Nathgabet/BE_L3_EEA-REL_PV/docs pour le rapport/MPPT/PV_H.jpg

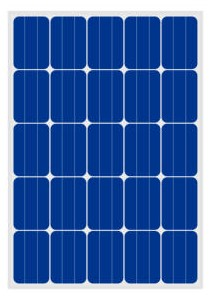
docs pour le rapport/MPPT/PV_H.jpg
