Nathgabet/BE_L3_EEA-REL_PV/docs pour le rapport/Capteur de température/demande de signal plus com.pdf

02/05/2023 15:44:55
Pico Technology www.picotech.com PicoScope 6 Version 6.12.9.2917 PicoScope 3203D MSO

8,0

6,0

4,0

2,0

0,0

-2,0

-4,0

-6,0

-8,0

10,0

-10,0

V
CC
19,73 | 19,86 | 19,98 | 20,11 | 20,24 | 20,36 | 20,49 | 20,62 | 20,74 | 20,87 | 21,0
ms
