Nathgabet/BE_L3_EEA-REL_PV/docs pour le rapport/Capteur de température/signal complet.pdf

02/05/2023 15:44:55
Pico Technology www.picotech.com PicoScope 6 Version 6.12.9.2917 PicoScope 3203D MSO

8,0

6,0

4,0

2,0

0,0

-2,0

-4,0

-6,0

-8,0

10,0

-10,0

V
CC
-0,567 | 1,932 | 4,431 | 6,93 | 9,429 | 11,93 | 14,43 | 16,93 | 19,42 | 21,92 | 24,42
ms
