Nathgabet/BE_L3_EEA-REL_PV/docs pour le rapport/Capteur de température/trame.pdf

02/05/2023 15:44:55
Pico Technology www.picotech.com PicoScope 6 Version 6.12.9.2917 PicoScope 3203D MSO

8,0

6,0

4,0

2,0

0,0

-2,0

-4,0

-6,0

-8,0

10,0

-10,0

V
CC
19,73 | 20,2 | 20,67 | 21,14 | 21,61 | 22,08 | 22,55 | 23,01 | 23,48 | 23,95 | 24,42
ms
