Nathgabet/BE_L3_EEA-REL_PV/docs pour le rapport/Hacheur/AOP/amplificateur_non_inversseur.pdf

21/03/2023 17:08:42
Pico Technology www.picotech.com PicoScope 6 Version 6.12.9.2917 PicoScope 3203D MSO

8,0

6,0

4,0

2,0

0,0

-2,0

-4,0

-6,0

-8,0

10,0

-10,0

V
CC

16,0

12,0

8,0

4,0

0,0

-4,0

-8,0

-12,0

-16,0

20,0

-20,0

V
CC
0,0 | 5,0 | 10,0 | 15,0 | 20,0 | 25,0 | 30,0 | 35,0 | 40,0 | 45,0 | 50,0
ms
