Nathgabet/BE_L3_EEA-REL_PV/Document d'aide/projet_chargeur_de_batterie-par-PV.pdf

# Chargeur de batteries par

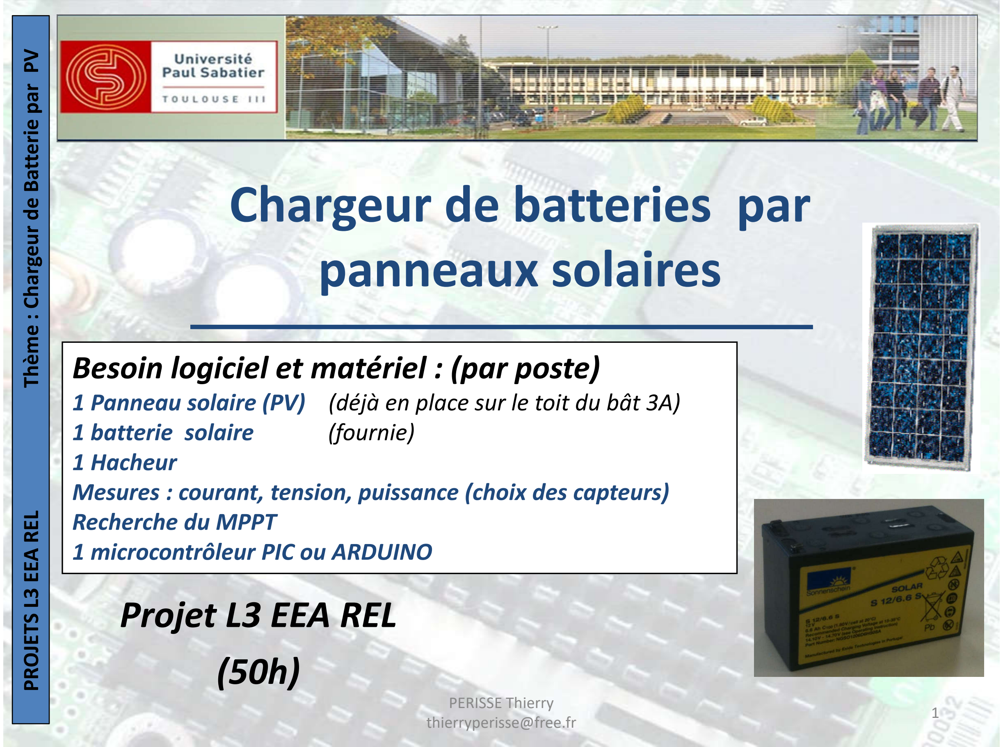
[picture p33: page 1]

PROJETS L3 EEA REL Thème : Chargeur de Batterie par PV

1 PERISSE Thierry
thierryperisse@free.fr

# panneaux solaires

## Besoin logiciel et matériel : (par poste)

### 1 Panneau solaire (PV) (déjà en place sur le toit du bât 3A) 1 batterie solaire (fournie) 1 Hacheur

Mesures : courant, tension, puissance (choix des capteurs) Recherche du MPPT

### 1 microcontrôleur PIC ou ARDUINO

## Projet L3 EEA REL

(50h)

## Chargeur de batteries par panneaux solaires

## L’objectif du projet est de construire un chargeur de

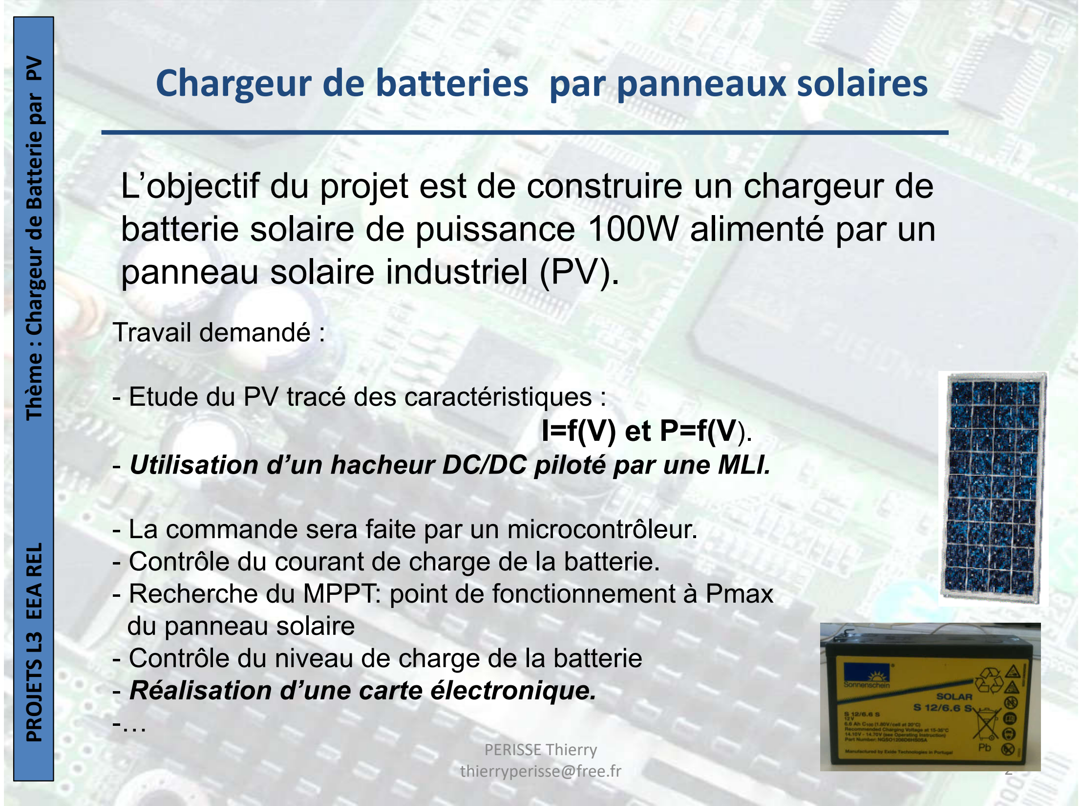
[picture p34: page 2]

PROJETS L3 EEA REL Thème : Chargeur de Batterie par PV

PERISSE Thierry
thierryperisse@free.fr | 2

## batterie solaire de puissance 100W alimenté par un

panneau solaire industriel (PV).

Travail demandé :

- Etude du PV tracé des caractéristiques :
I=f(V) et P=f(V).
- Utilisation d’un hacheur DC/DC piloté par une MLI.
- La commande sera faite par un microcontrôleur.
- Contrôle du courant de charge de la batterie.
- Recherche du MPPT: point de fonctionnement à Pmax du panneau solaire
- Contrôle du niveau de charge de la batterie
- Réalisation d’une carte électronique.
-…
