Nathgabet/BE_L3_EEA-REL_PV/docs pour le rapport/Schéma de cablage/Document1.docx

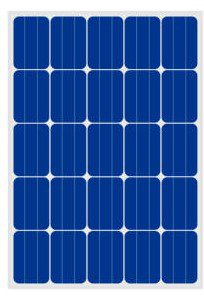
[picture p46: figure]
PV_H
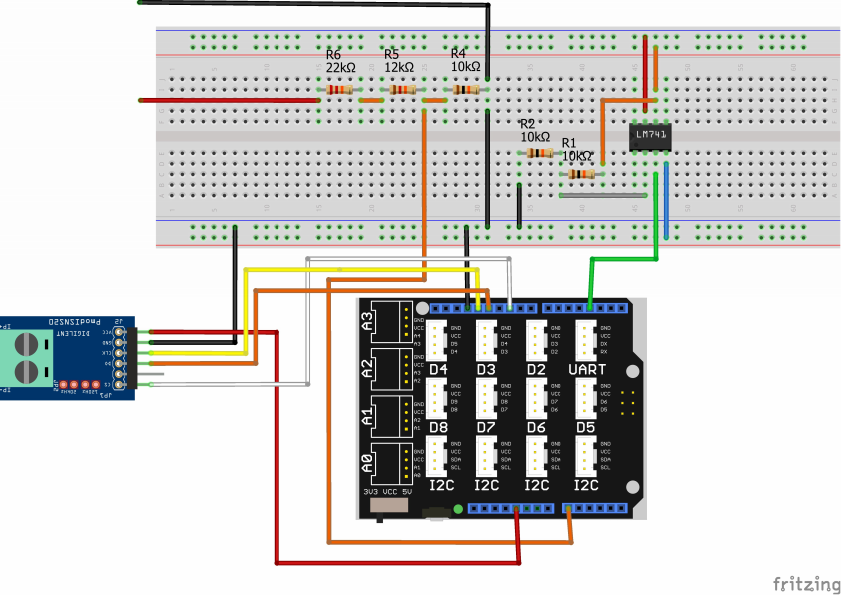
[picture p47: figure]
