Nathgabet/BE_L3_EEA-REL_PV/docs pour le rapport/Schéma de cablage/Document1(1).pdf

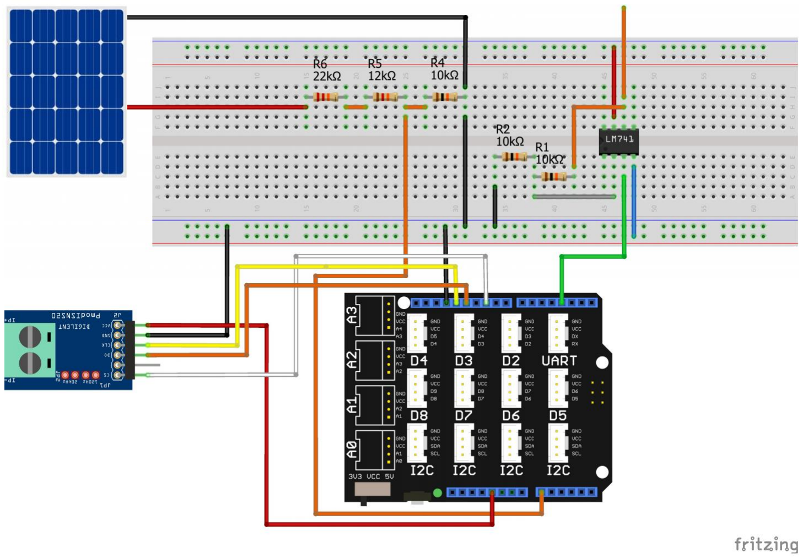
[picture p48: figure]
