Nathgabet/BE_L3_EEA-REL_PV/docs pour le rapport/PmodISNS20/Graphe des valeur.pdf

Courant réel Courant du capteur sans correction | Courant du capteur avec correction
0 A | 0 A | 0 A
0,5 A | 0,35 A | 0,4 A
1 A | 0,8 A | 0,93 A
1,5 A | 1,27 A | 1,43 A
2 A | 1,71 A | 1,94 A
2,5 A | 2,17 A | 2,44 A

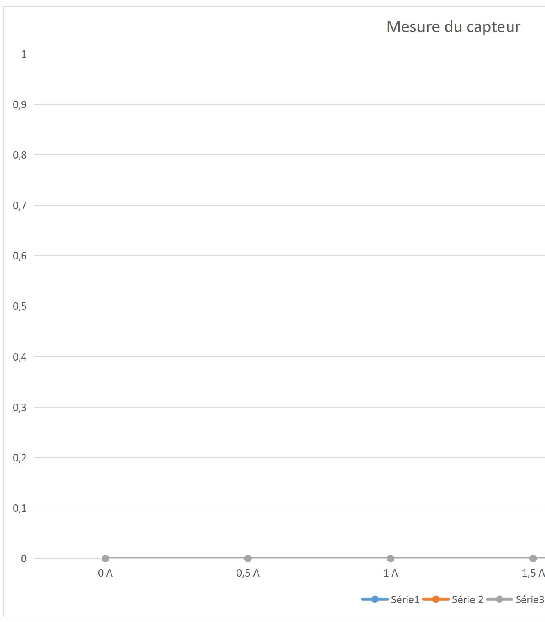
[picture p49: figure]

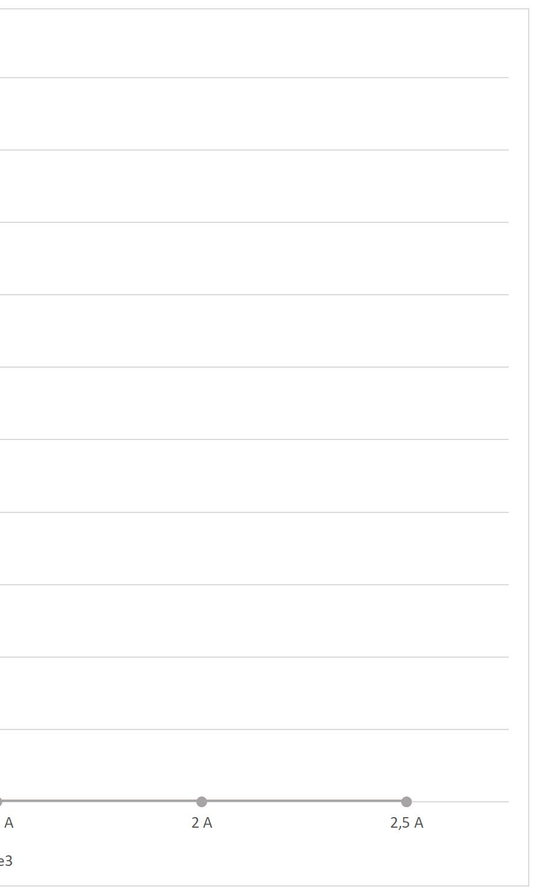
[picture p50: figure]
