Nathgabet/BE_L3_EEA-REL_PV/docs pour le rapport/Hacheur/AOP/SDS00001.png

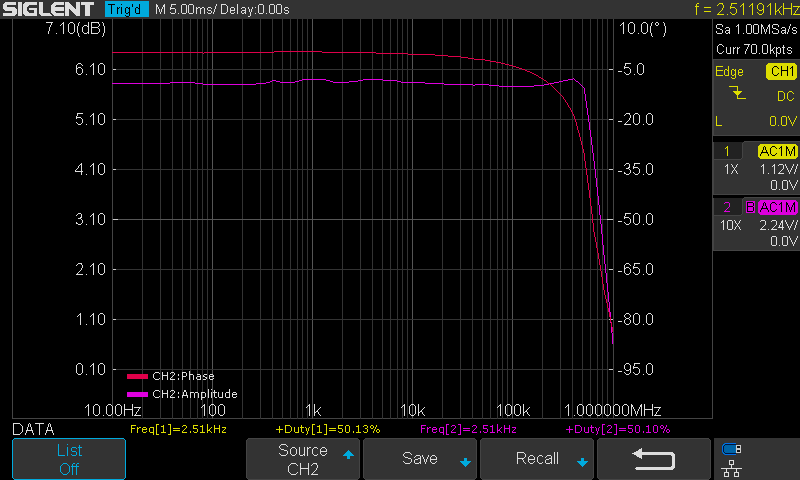
docs pour le rapport/Hacheur/AOP/SDS00001.png
