Nathgabet/BE_L3_EEA-REL_PV/docs pour le rapport/Hacheur/PWM/registre 2.png

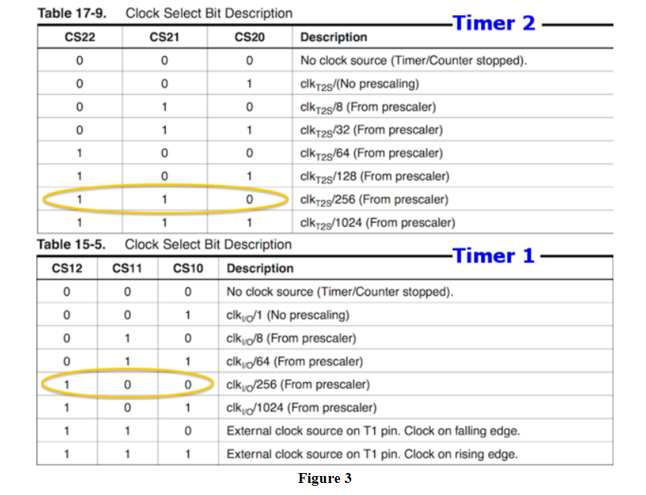
docs pour le rapport/Hacheur/PWM/registre 2.png
