Nathgabet/BE_L3_EEA-REL_PV/docs pour le rapport/Hacheur/PWM/registre PWM.png

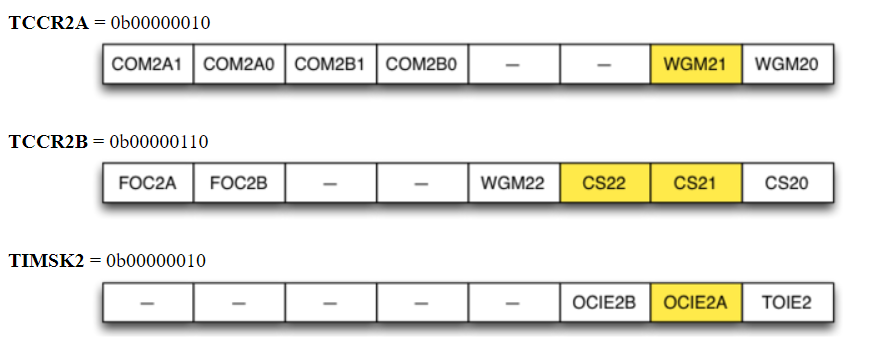
docs pour le rapport/Hacheur/PWM/registre PWM.png
