Nathgabet/BE_L3_EEA-REL_PV/docs pour le rapport/Hacheur/PWM/reglage_C0M0A.png

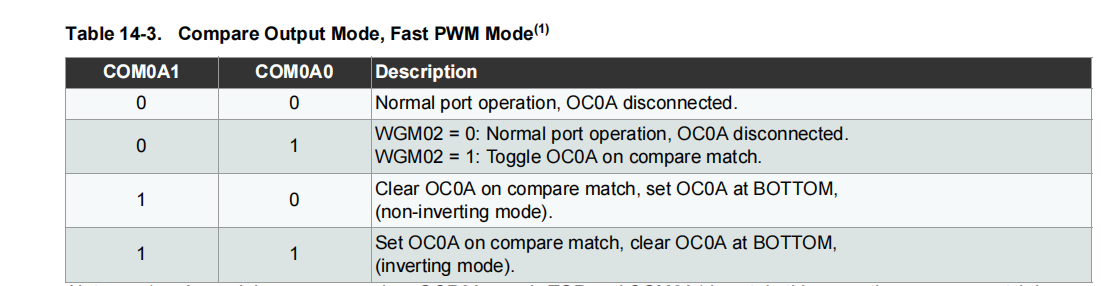
docs pour le rapport/Hacheur/PWM/reglage_C0M0A.png
