Nathgabet/BE_L3_EEA-REL_PV/docs pour le rapport/Hacheur/PWM/reglage_CS0.png

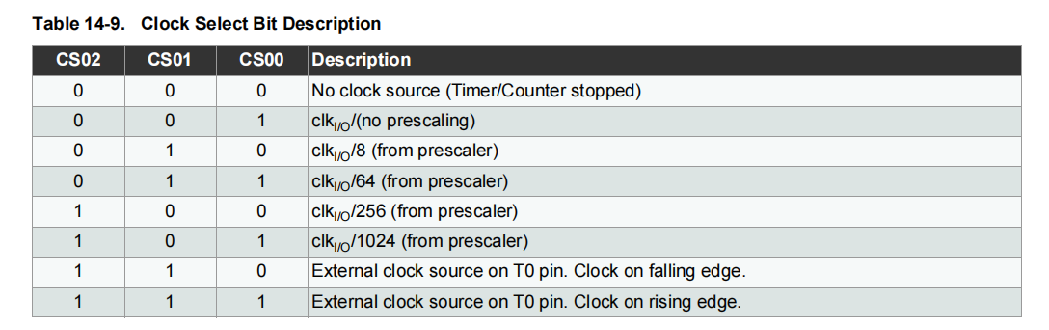
docs pour le rapport/Hacheur/PWM/reglage_CS0.png
