Nathgabet/BE_L3_EEA-REL_PV/docs pour le rapport/Hacheur/PWM/reglage_WGM0.png

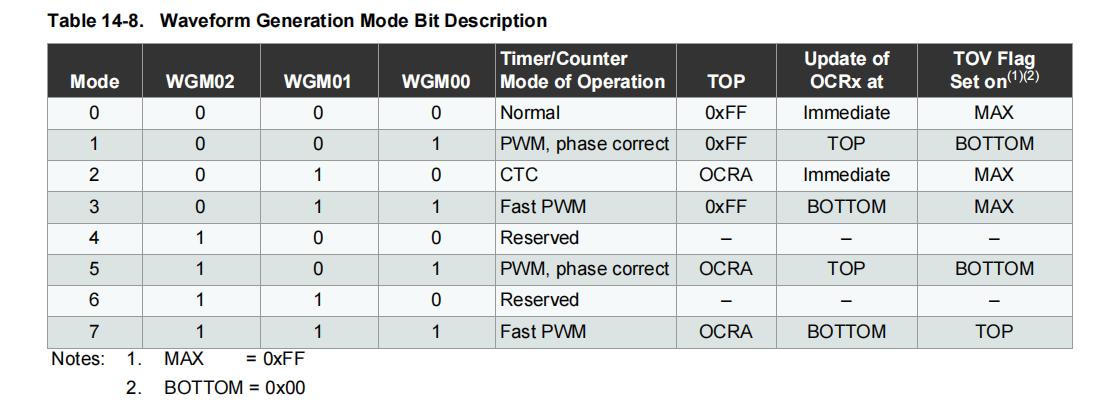
docs pour le rapport/Hacheur/PWM/reglage_WGM0.png
