Nathgabet/BE_L3_EEA-REL_PV/docs pour le rapport/Hacheur/PWM/TCCR0A.png

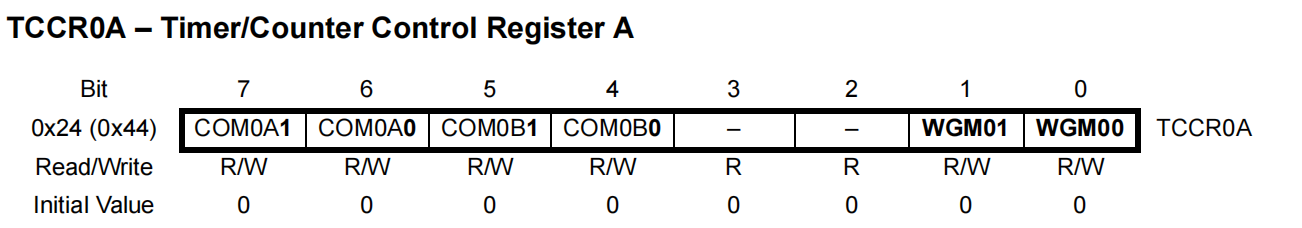
docs pour le rapport/Hacheur/PWM/TCCR0A.png
