Nathgabet/BE_L3_EEA-REL_PV/docs pour le rapport/MPPT/Scope/scope_0.png

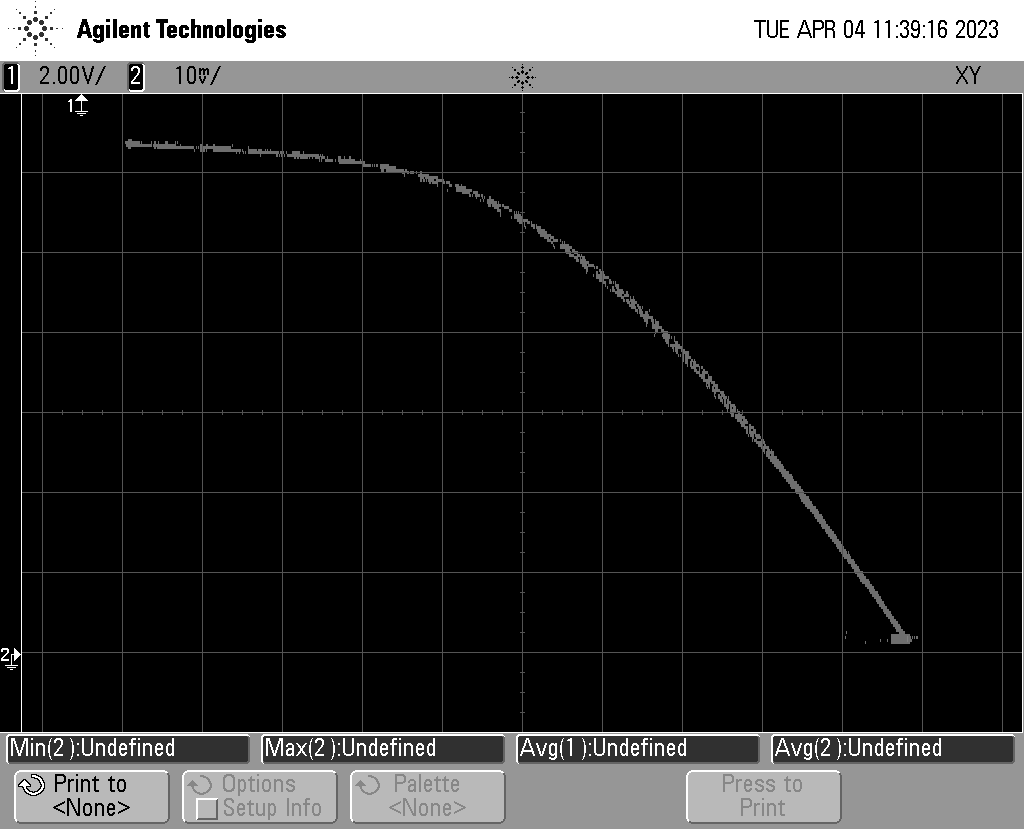
docs pour le rapport/MPPT/Scope/scope_0.png
