Nathgabet/BE_L3_EEA-REL_PV/docs pour le rapport/PmodISNS20/Image/affectation.png

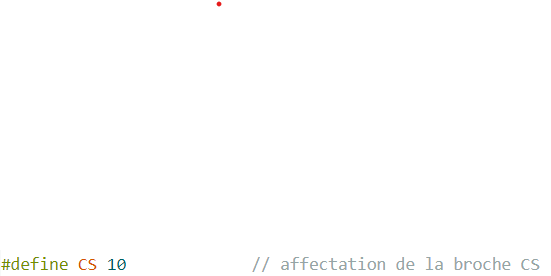
docs pour le rapport/PmodISNS20/Image/affectation.png
