Nathgabet/BE_L3_EEA-REL_PV/docs pour le rapport/PmodISNS20/Image/Scope/1676983223477.png

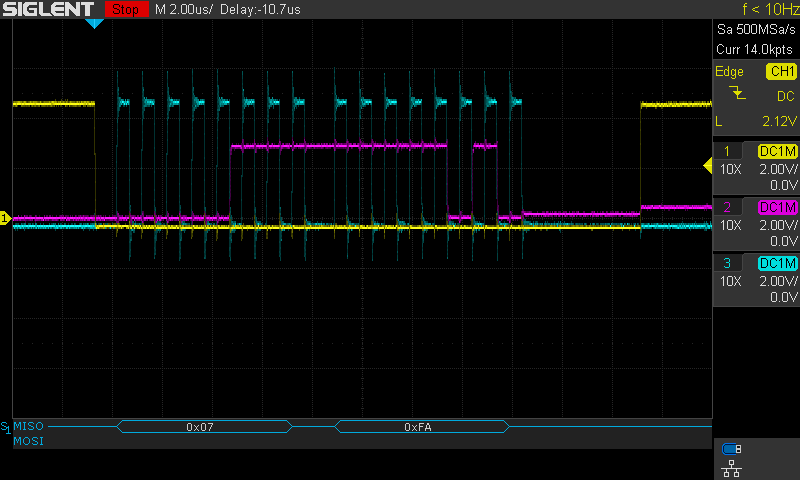
docs pour le rapport/PmodISNS20/Image/Scope/1676983223477.png
