Nathgabet/BE_L3_EEA-REL_PV/docs pour le rapport/PmodISNS20/Image/Scope/scope_0.png

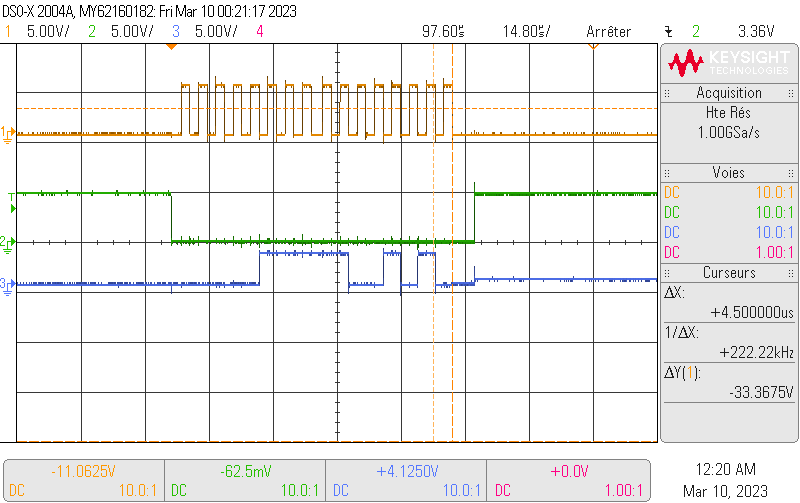
docs pour le rapport/PmodISNS20/Image/Scope/scope_0.png
