Nathgabet/BE_L3_EEA-REL_PV/docs pour le rapport/PmodISNS20/Nouveau dossier/scope_2.png

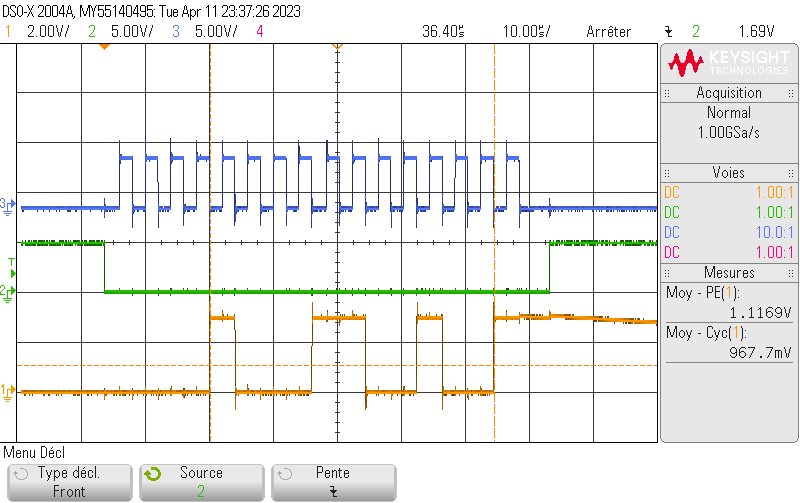
docs pour le rapport/PmodISNS20/Nouveau dossier/scope_2.png
