Nathgabet/BE_L3_EEA-REL_PV/docs pour le rapport/Schéma de cablage/Arduino+Shield.jpg

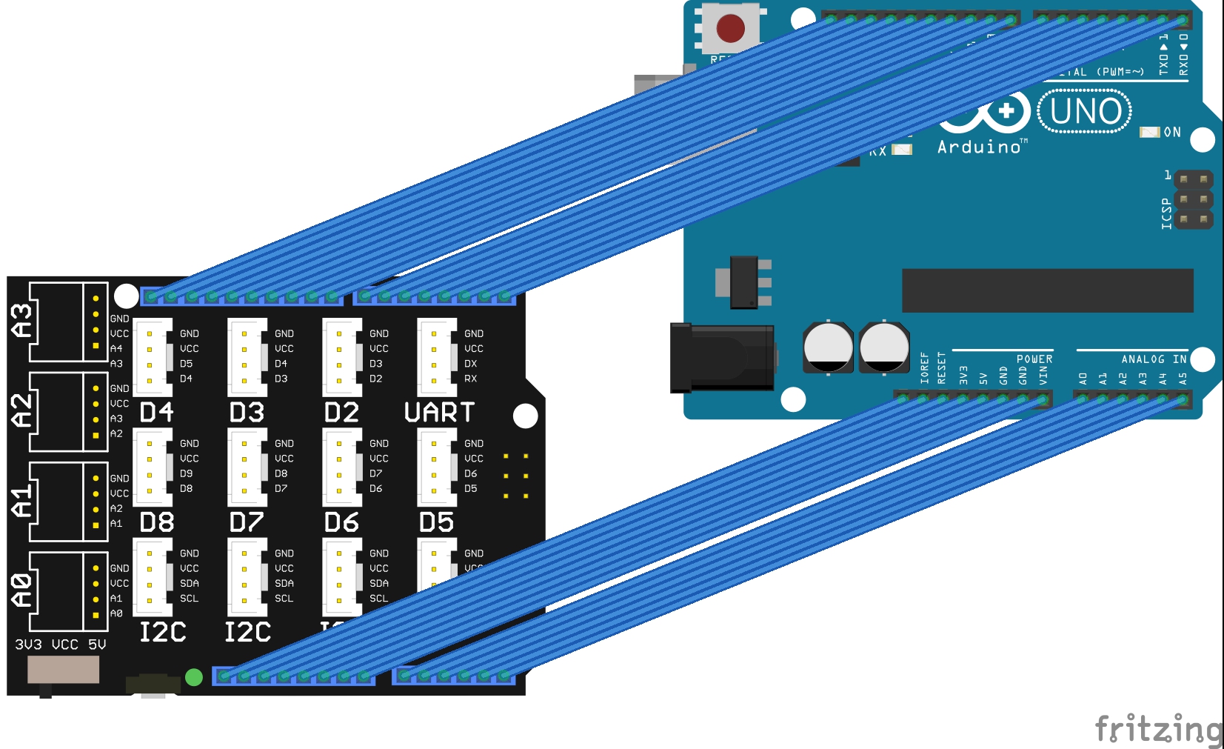
docs pour le rapport/Schéma de cablage/Arduino+Shield.jpg
