Nathgabet/BE_L3_EEA-REL_PV/docs pour le rapport/Schéma de cablage/shield+AOP_bb.png

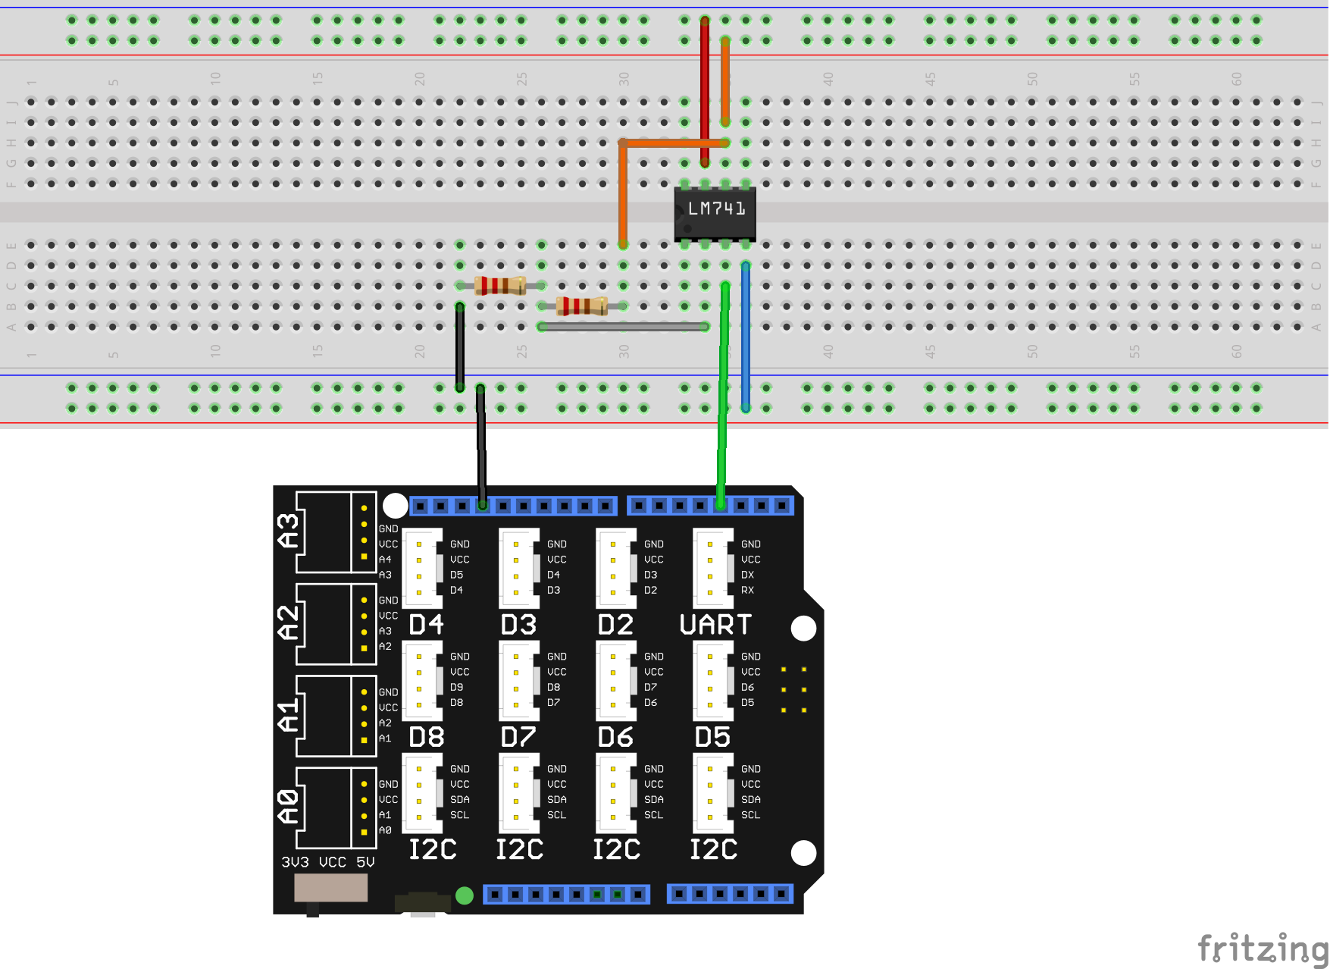
docs pour le rapport/Schéma de cablage/shield+AOP_bb.png
