Nathgabet/BE_L3_EEA-REL_PV/docs pour le rapport/Schéma de cablage/Shield+PmodISNS20.jpg

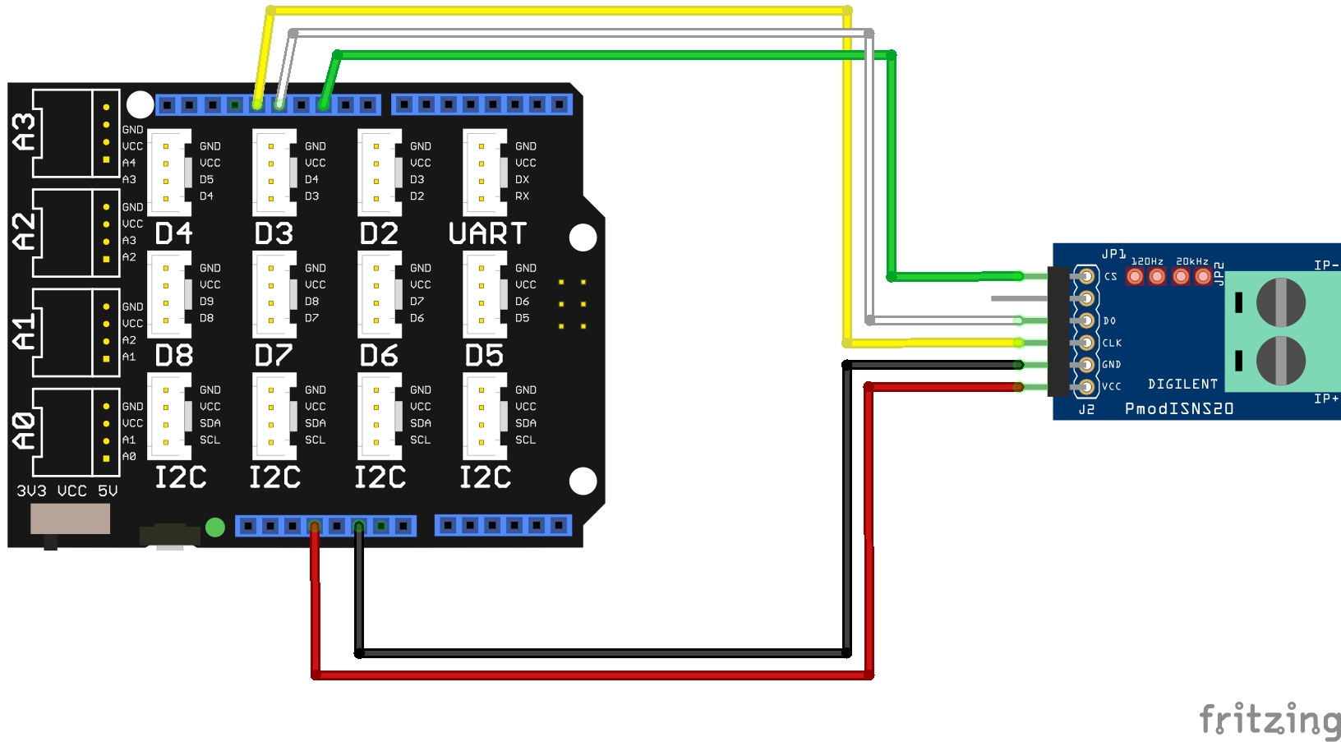
docs pour le rapport/Schéma de cablage/Shield+PmodISNS20.jpg
