Nathgabet/BE_L3_EEA-REL_PV/docs pour le rapport/Schéma de cablage/Tension PV A0.png

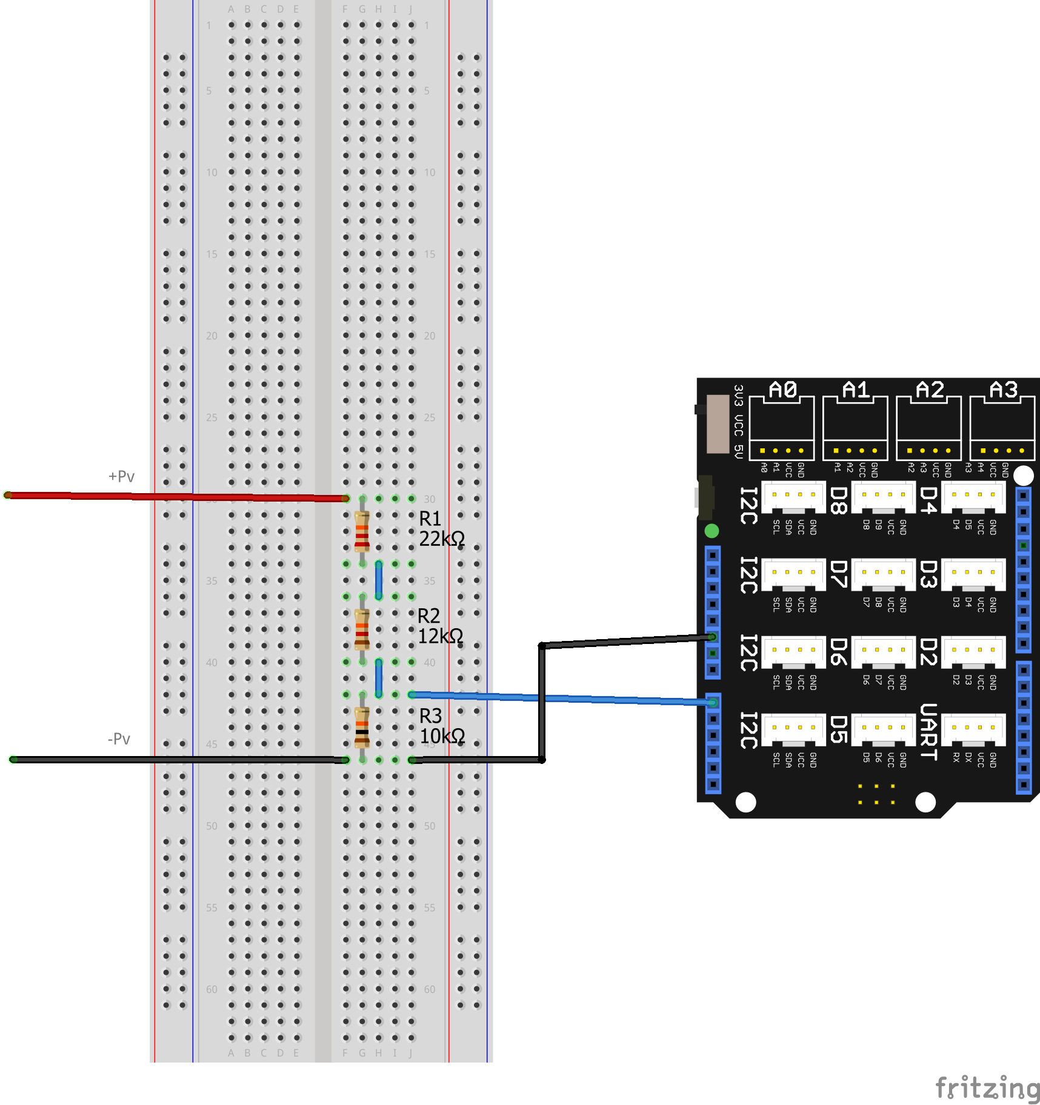
docs pour le rapport/Schéma de cablage/Tension PV A0.png
