Nathgabet/BE_L3_EEA-REL_PV/docs pour le rapport/MPPT/Scope/print_00.png

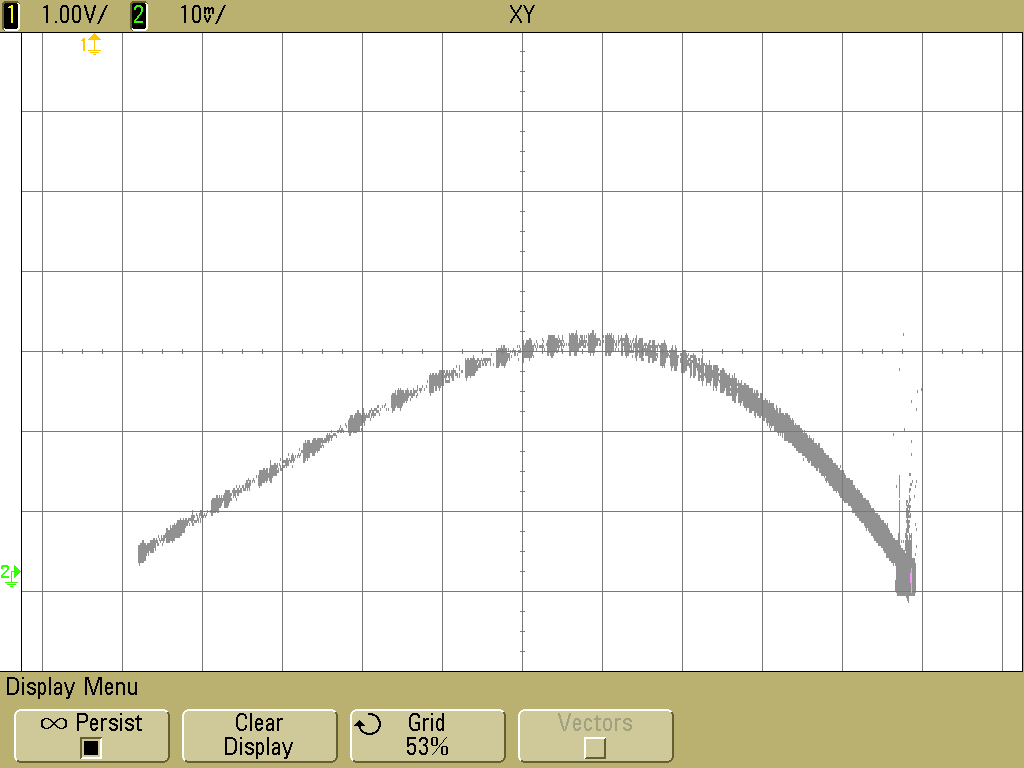
docs pour le rapport/MPPT/Scope/print_00.png
