Nathgabet/BE_L3_EEA-REL_PV/docs pour le rapport/PmodISNS20/meusure_oscillo_CS_CLK.pdf

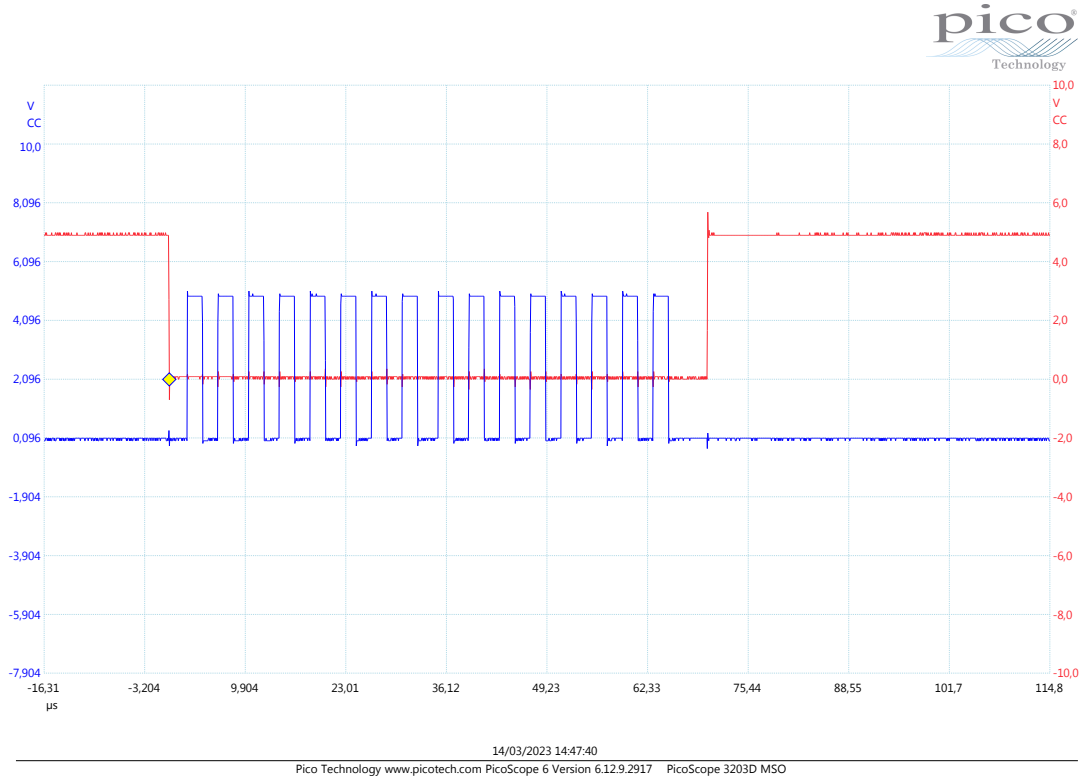
[picture p70: page 1]
Pico Technology www.picotech.com PicoScope 6 Version 6.12.9.2917; PicoScope 3203D MSO
