Nathgabet/BE_L3_EEA-REL_PV/docs pour le rapport/Hacheur/PWM/PWM_14.pdf

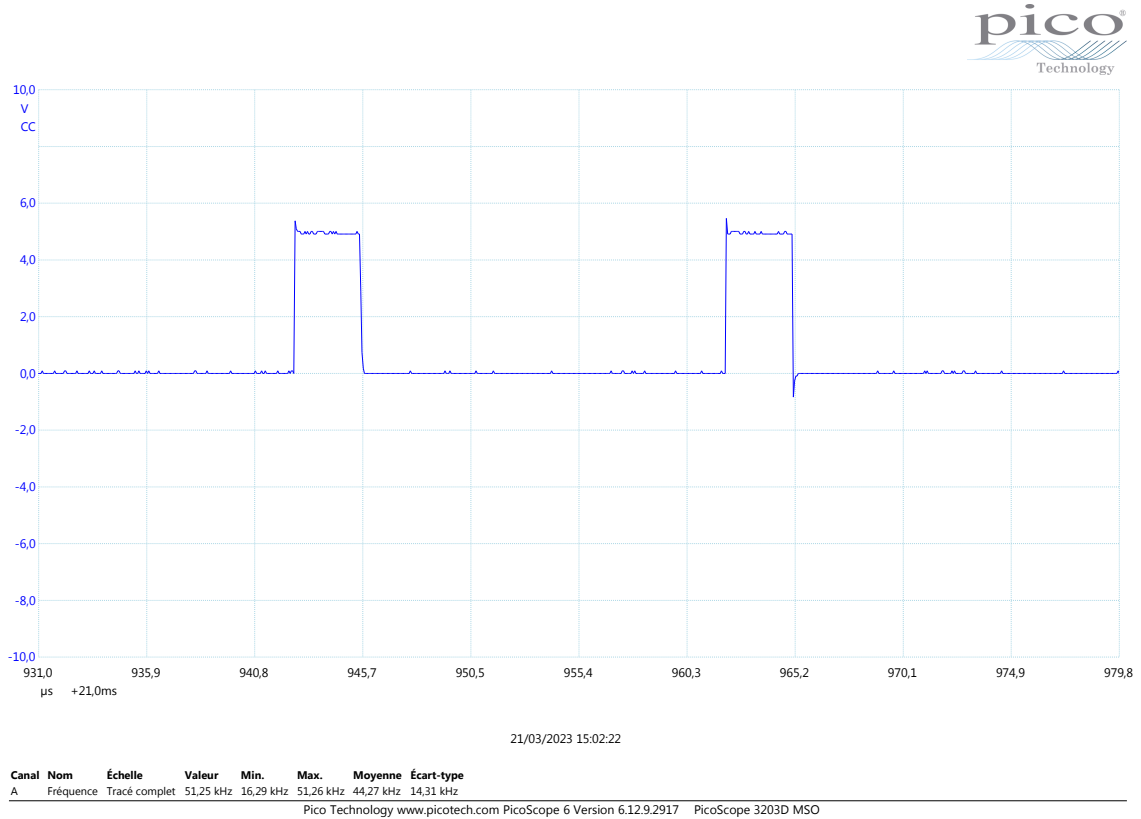
[picture p75: page 1]
Canal Nom; Échelle; Valeur; Min.; Max.; Moyenne Écart-type; Pico Technology www.picotech.com PicoScope 6 Version 6.12.9.2917; PicoScope 3203D MSO

A Fréquence Tracé complet 51,25 kHz 16,29 kHz 51,26 kHz 44,27 kHz 14,31 kHz
