Nathgabet/BE_L3_EEA-REL_PV/docs pour le rapport/Schéma de cablage/shield+AOP+pont+LCD+CS_bb.pdf

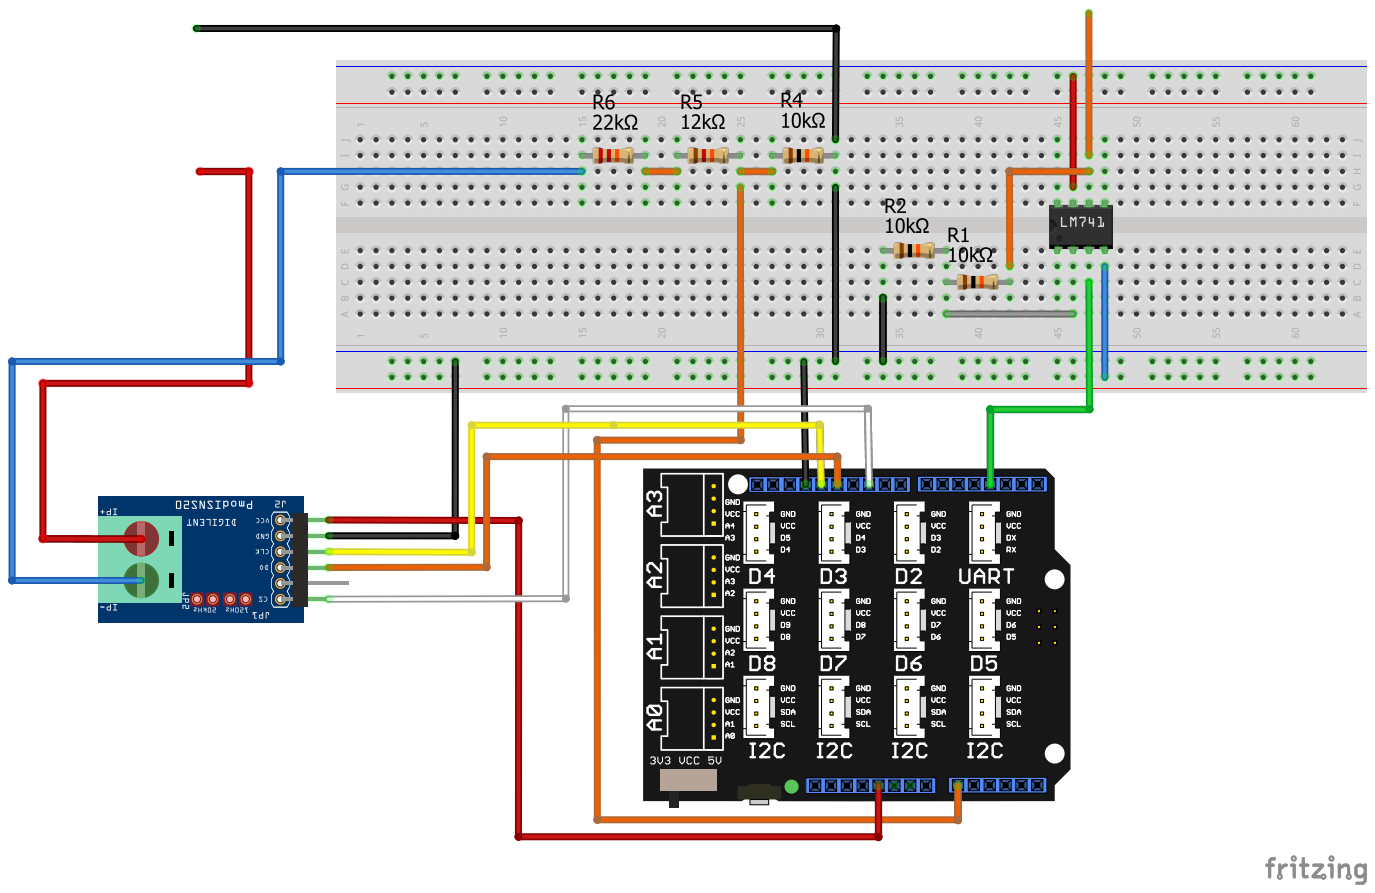
[picture p77: page 1]
