Nathgabet/BE_L3_EEA-REL_PV/docs pour le rapport/Schéma de cablage/Shield+DHT11_bb.pdf

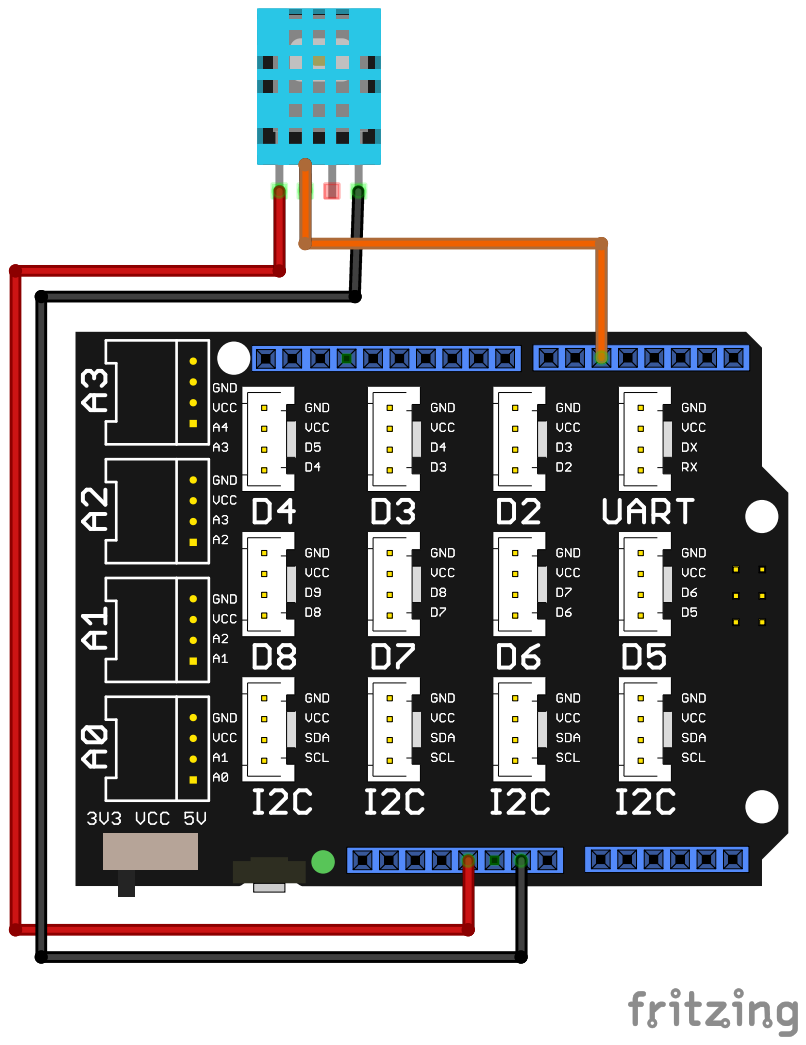
[picture p78: page 1]
