Nathgabet/BE_L3_EEA-REL_PV/docs pour le rapport/Schéma de cablage/potentiometre + afficheur_bb.pdf

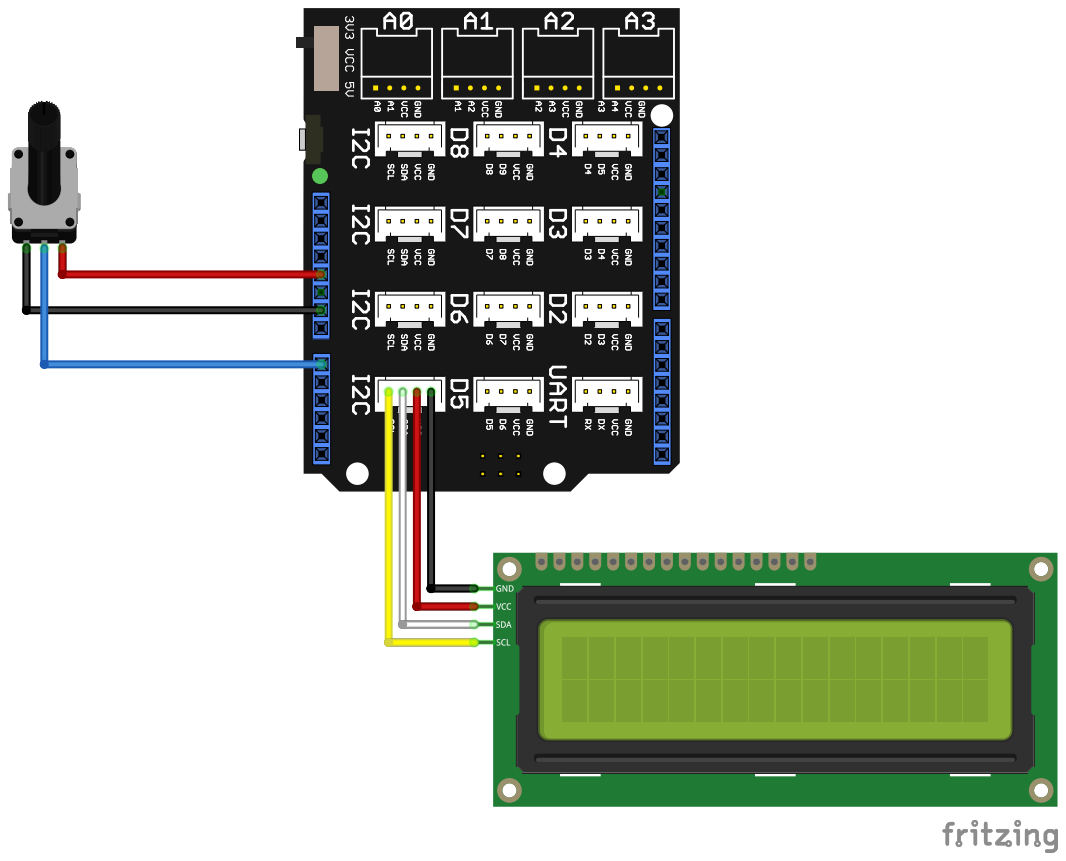
[picture p79: page 1]
