Nathgabet/BE_L3_EEA-REL_PV/docs pour le rapport/Schéma de cablage/shield+AOP_bb.pdf

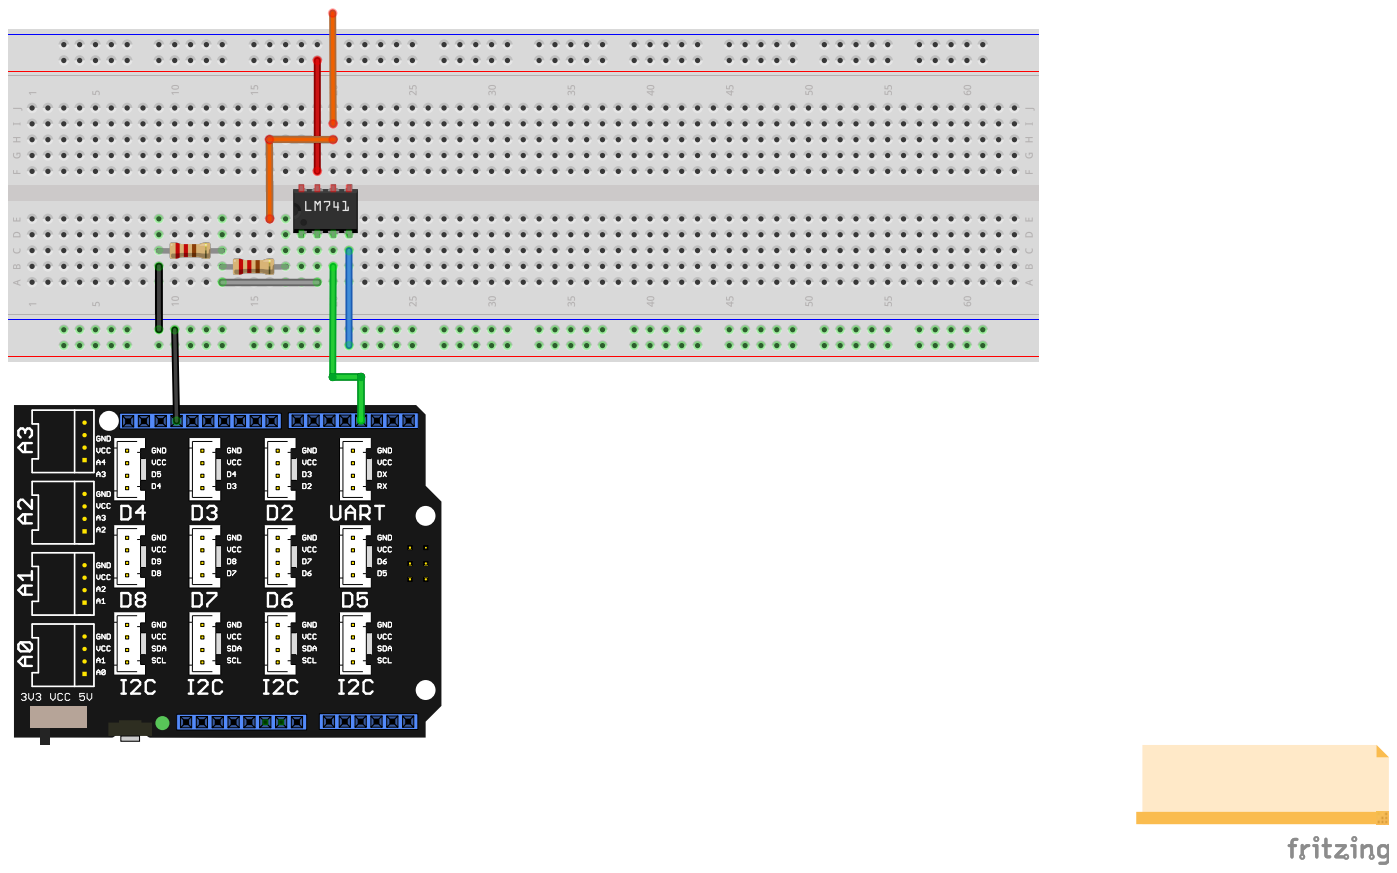
[picture p80: page 1]
