Nathgabet/BE_L3_EEA-REL_PV/docs pour le rapport/Schéma de cablage/Shield+PmodISNS20_bb.pdf

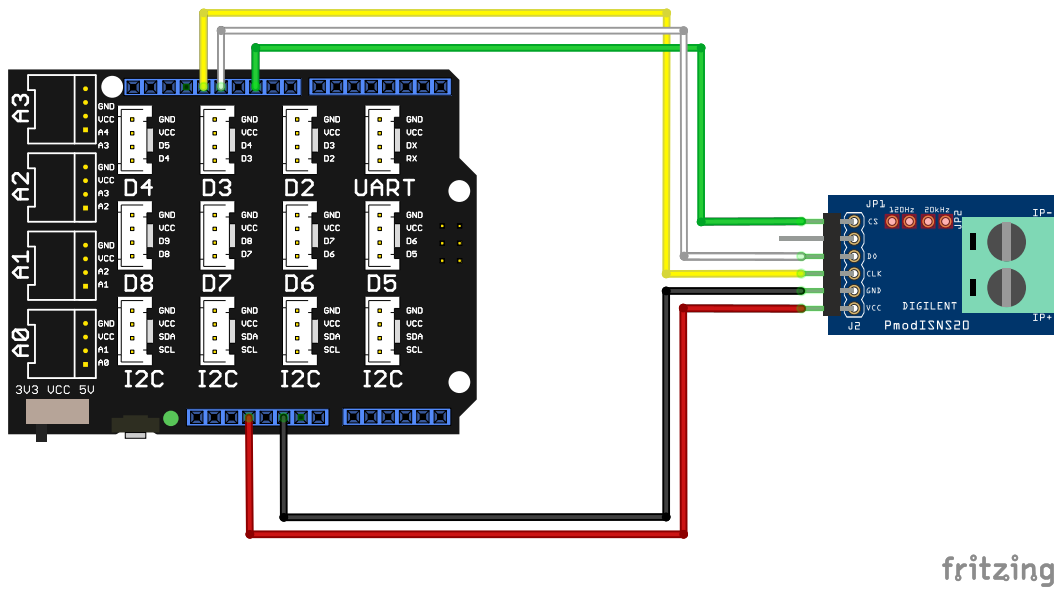
[picture p81: page 1]
