Nathgabet/BE_L3_EEA-REL_PV/docs pour le rapport/Schéma de cablage/Tension PV A0_bb.pdf

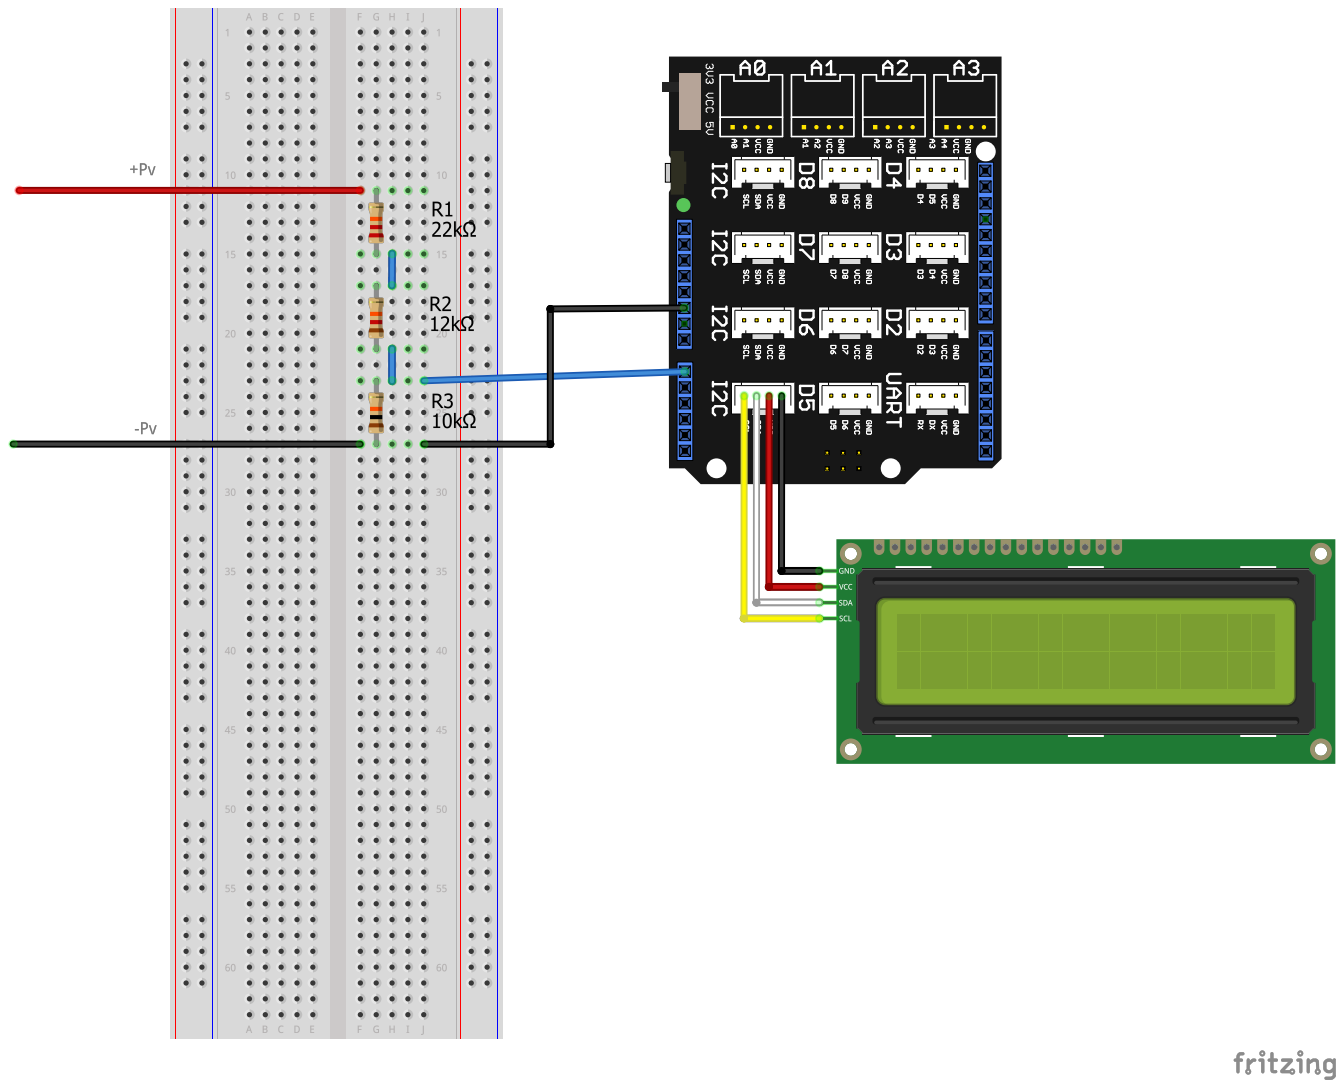
[picture p82: page 1]
