Nathgabet/BE_L3_EEA-REL_PV/docs pour le rapport/Schéma de cablage/Arduino et Shield.pdf

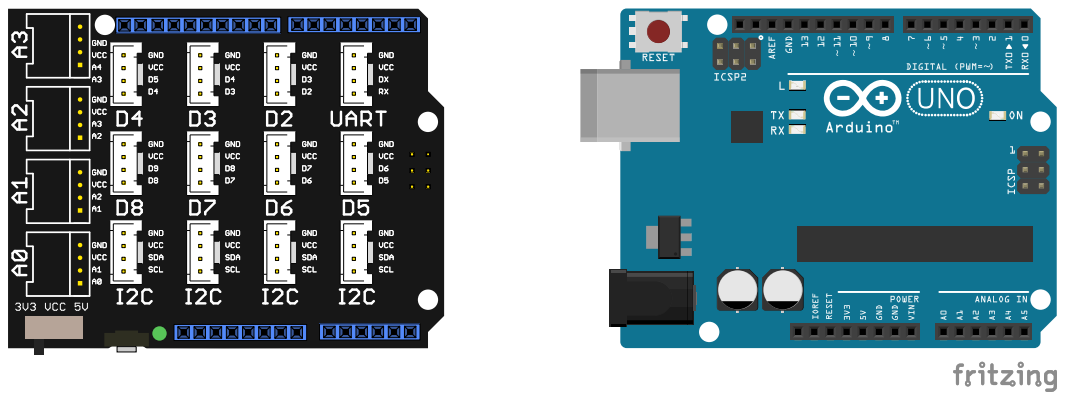
[picture p83: page 1]
