Nathgabet/BE_L3_EEA-REL_PV/docs pour le rapport/Schéma de cablage/Arduino+Shield_bb.pdf

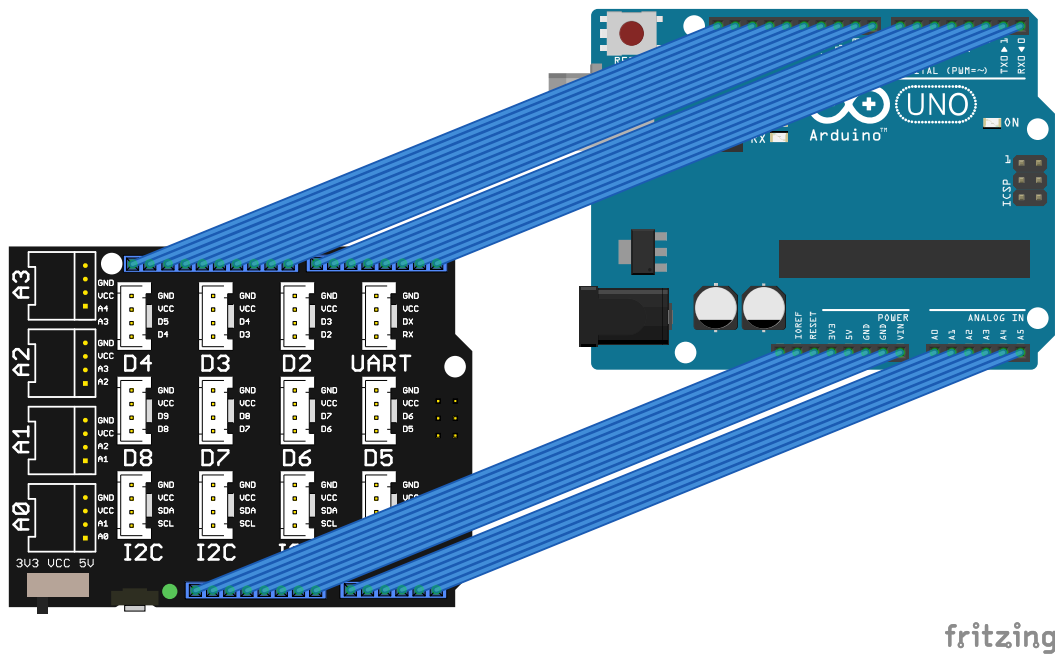
[picture p84: page 1]
