Nathgabet/BE_L3_EEA-REL_PV/docs pour le rapport/Schéma de cablage/Shield+lcdI2C_bb.pdf

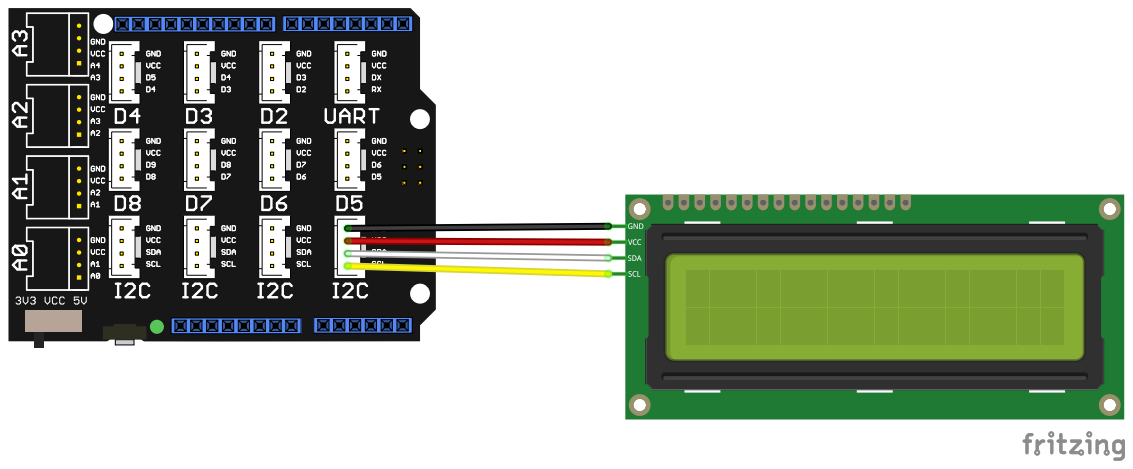
[picture p85: page 1]
