Nathgabet/BE_L3_EEA-REL_PV/docs pour le rapport/MPPT/Algorithme/MPPT.pdf

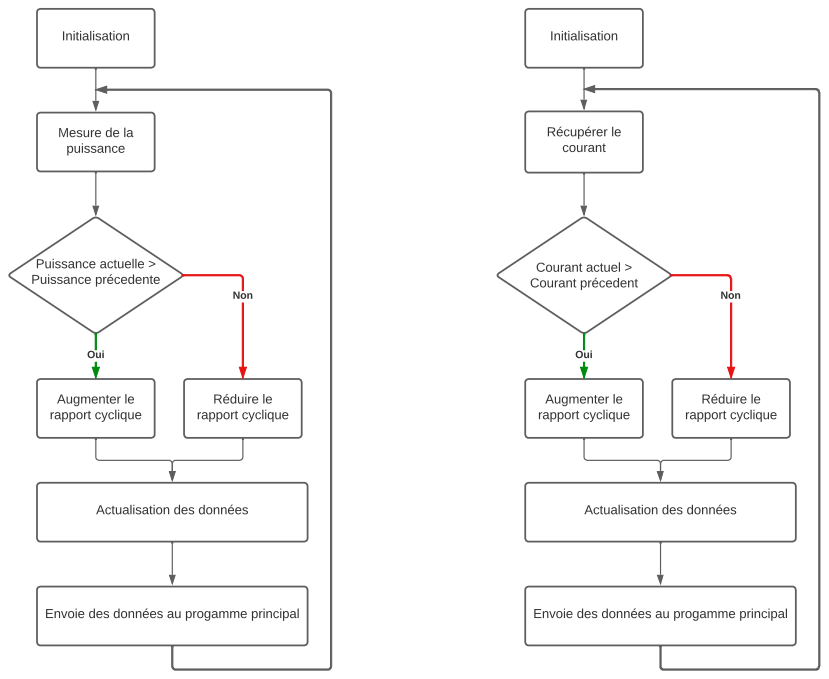
[picture p86: page 1]
Initialisation; Augmenter le rapport cyclique; Réduire le rapport cyclique; Puissance actuelle > Puissance précedente; Non; Oui; Récupérer le courant; Courant actuel > Courant précedent

Mesure de la
puissance

Actualisation des données

Envoie des données au progamme principal
