Nathgabet/BE_L3_EEA-REL_PV/(list of files, drawings)

Other design files:
Schéma electrique/Arduino+Shield.fzz
Schéma electrique/potentiometre + afficheur.fzz
Schéma electrique/shield0.fzz
Schéma electrique/shield+AOP+pont+LCD+CS.fzz
Schéma electrique/shield+AOP.fzz
Schéma electrique/Shield+DHT11.fzz
Schéma electrique/Shield+lcdI2C.fzz
Schéma electrique/Shield+PmodISNS20.fzz
Schéma electrique/Tension PV A0.fzz
