Nathgabet/BE_L3_EEA-REL_PV/Programme Arduino/PWM_50kHz/PWM_50kHz.ino

#define pinPotentiometre A1

//variable

int PWM = 1;

void setup() {

  
  pinMode(3, OUTPUT);   // sortie Timer B

  TCCR2A = 0b00100011;  //00=> OCOA deconnecter(COM2A1:0), 10=> sortie OCOB non inverseuse(COM2B1:0), 00=> reserver, 11=> Fast PWM(WGM01:00)
  TCCR2B = 0b00001010;  //00=> utiliser pour mode non pwm (FOC2A:FOC2B), 00=> reserver, 1=> Fast PWM(WGM02), 010=> diviseur de 8 pour la clock (CS00:01:02)

  OCR2A = 39;           //valeur max du comparateur
  OCR2B = 0;           //valeur a comparer (duty cycle 0 to OCR2A)
  
  sei();       // Active l'interruption globale

  Serial.begin(9600);
}

void loop() {
  /*
  tensionPotentiometre = analogRead(pinPotentiometre);//on lit la valeur analogique du potentiometre
  OCR2B = (OCR2A / 255) *tensionPotentiometre;
for (int i = 1; i <= 14; i++) {
    OCR2B = (OCR2A / 15.0) * i;  //on multipli la valeur du DC entre [1;14]
    delay(2000);
  }
 */
  Serial.print("loop1 ");
   Serial.println(PWM);

  duty(&PWM);
  OCR2B = (OCR2A / 15.0) * PWM;
   Serial.print("loop2 ");
   Serial.println(PWM);
  delay(2000);
}

void duty(int *PWM) {

  *PWM = *PWM + 1;
   Serial.print("void1 ");
   Serial.println(*PWM);
  if (*PWM > 14){
    *PWM = 14;
  }
  Serial.print("void2 ");
  Serial.println(*PWM);

}
