Nathgabet/BE_L3_EEA-REL_PV/Programme Arduino/affichage/affichage.ino

#include <Wire.h>
#include "rgb_lcd.h"

rgb_lcd lcd;
int Tension = A0;
int In=12;
int Courant= 6;

void setup() {

lcd.begin(16,2);

}

void loop() {

 aff_I(In,Courant);
 delay(1000);
}


void aff_I(int tension, int courant){
lcd.clear();
lcd.setCursor(0,0);
lcd.print("Vpv:");
lcd.setCursor(4,0);
lcd.print(tension*4.8);
lcd.setCursor(0,1);
lcd.print("Ipv:");
lcd.setCursor(4,1);
lcd.print(courant);
Serial.println("test sur fritzing");
}
